Raptor-Tech/ulc-hardware/PerceptPCB_v1b.kicad_pcb

## KiCad design PerceptPCB_v1b.kicad_pcb (2026-10-30)

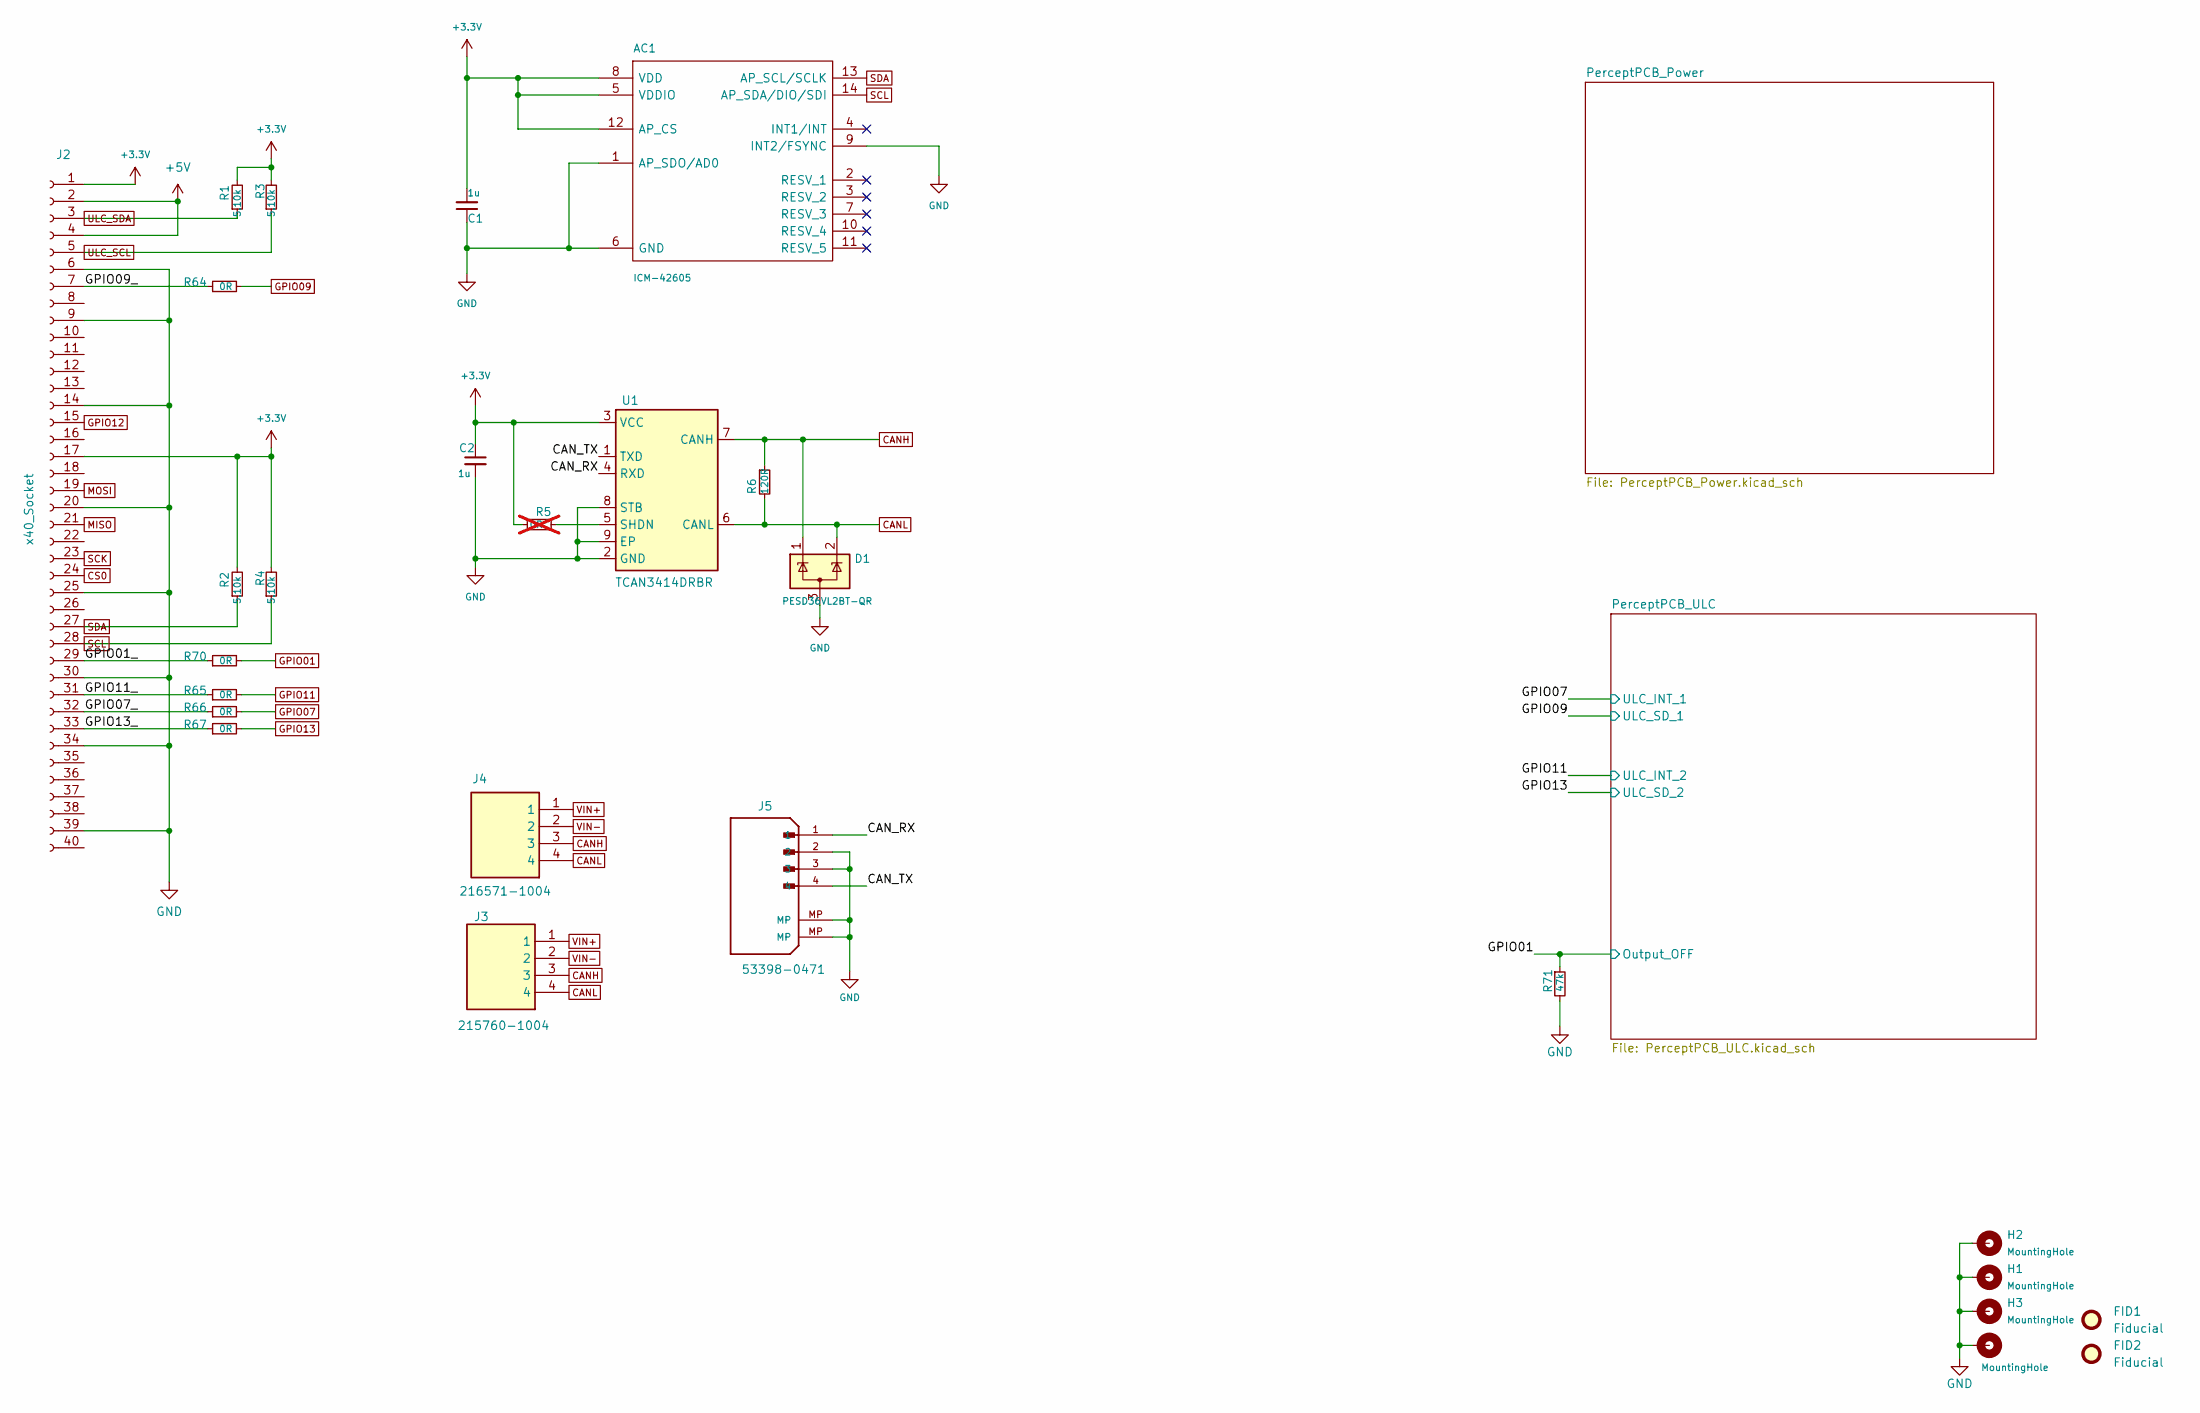
[picture p1: schematic PerceptPCB_v1b.kicad_sch, PerceptPCB v1]

Parts:
AC1: ICM-42605; IIM42352; MPN ICM-42605
C1, C2: 1u; C_0603_1608Metric; MPN C1608X7R2A105K080AC
D1: PESD36VL2BT-QR; SOT-23; MPN PESD36VL2BT-QR
FID1, FID2: Fiducial; Fiducial_1mm_Mask2mm
H1, H2, H3: MountingHole; MountingHole_2.7mm_M2.5_ISO14580_Pad
H4: MountingHole; Mounting_Wuerth_WA-SMSI-M1.6_H2.5mm_ThreadDepth1.5mm_NoNPTH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
J2: x40_Socket; PinSocket_2x20_P2.54mm_Vertical_SMD; MPN HLE-120-02-L-DV-BE-A-P-TR
J3: 215760-1004; 215760-YY04; Mouser Part Number 538-215760-1004
J4: 216571-1004; 216571-YY04_1; Mouser Part Number 538-216571-1004
J5: 53398-0471; Molex_PicoBlade_53398-0471_1x04-1MP_P1.25mm_Vertical; MPN 53398-0471
R1, R2, R3, R4: 5.10k; R_0603_1608Metric; MPN RMCF0603FT5K10
R5: 0R; R_0603_1608Metric; MPN RMCF0603ZT0R00; not fitted
R6: 120R; R_0805_2012Metric; MPN CRCW0805120RFKEA
R64, R65, R66, R67, R70: 0R; R_0603_1608Metric; MPN RMCF0603ZT0R00
R71: 47k; R_0603_1608Metric; MPN RMCF0603FT47k0
U1: TCAN3414DRBR; SON65P300X300X100-9N-D; MPN TCAN3414DRBR

Connections:
+3.3V: AC1.5 (VDDIO), AC1.8 (VDD), AC1.12 (AP_CS), C1.2, C2.1, J2.1, J2.17, R1.2, R2.2, R3.2, R4.2, R5.1, U1.3 (VCC); also elsewhere on the board
+5V: J2.2, J2.4
/CAN_RX: J5.1, U1.4 (RXD)
/CAN_TX: J5.4, U1.1 (TXD)
/GPIO01_: J2.29, R70.1
/GPIO07_: J2.32, R66.1
/GPIO09_: J2.7, R64.1
/GPIO11_: J2.31, R65.1
/GPIO13_: J2.33, R67.1
CANH: D1.1 (K), J3.3, J4.3, R6.1, U1.7 (CANH)
CANL: D1.2 (K), J3.4, J4.4, R6.2, U1.6 (CANL)
CS0: J2.24
GND: AC1.1 (AP_SDO/AD0), AC1.6 (GND), AC1.9 (INT2/FSYNC), C1.1, C2.2, D1.3 (A), H1.1, H2.1, H3.1, H4.1, J2.6, J2.9, J2.14, J2.20, J2.25, J2.30, J2.34, J2.39, J5.2, J5.3, J5.MP, R71.2, U1.2 (GND), U1.8 (STB), U1.9 (EP); also elsewhere on the board
GPIO01: R70.2, R71.1; also elsewhere on the board
GPIO07: R66.2; also elsewhere on the board
GPIO09: R64.2; also elsewhere on the board
GPIO11: R65.2; also elsewhere on the board
GPIO12: J2.15
GPIO13: R67.2; also elsewhere on the board
MISO: J2.21
MOSI: J2.19
unnamed: R5.2, U1.5 (SHDN)
SCK: J2.23
SCL: AC1.14 (AP_SDA/DIO/SDI), J2.28, R4.1
SDA: AC1.13 (AP_SCL/SCLK), J2.27, R2.1
ULC_SCL: J2.5, R3.1; also elsewhere on the board
ULC_SDA: J2.3, R1.1; also elsewhere on the board
VIN+: J3.1, J4.1; also elsewhere on the board
VIN-: J3.2, J4.2; also elsewhere on the board

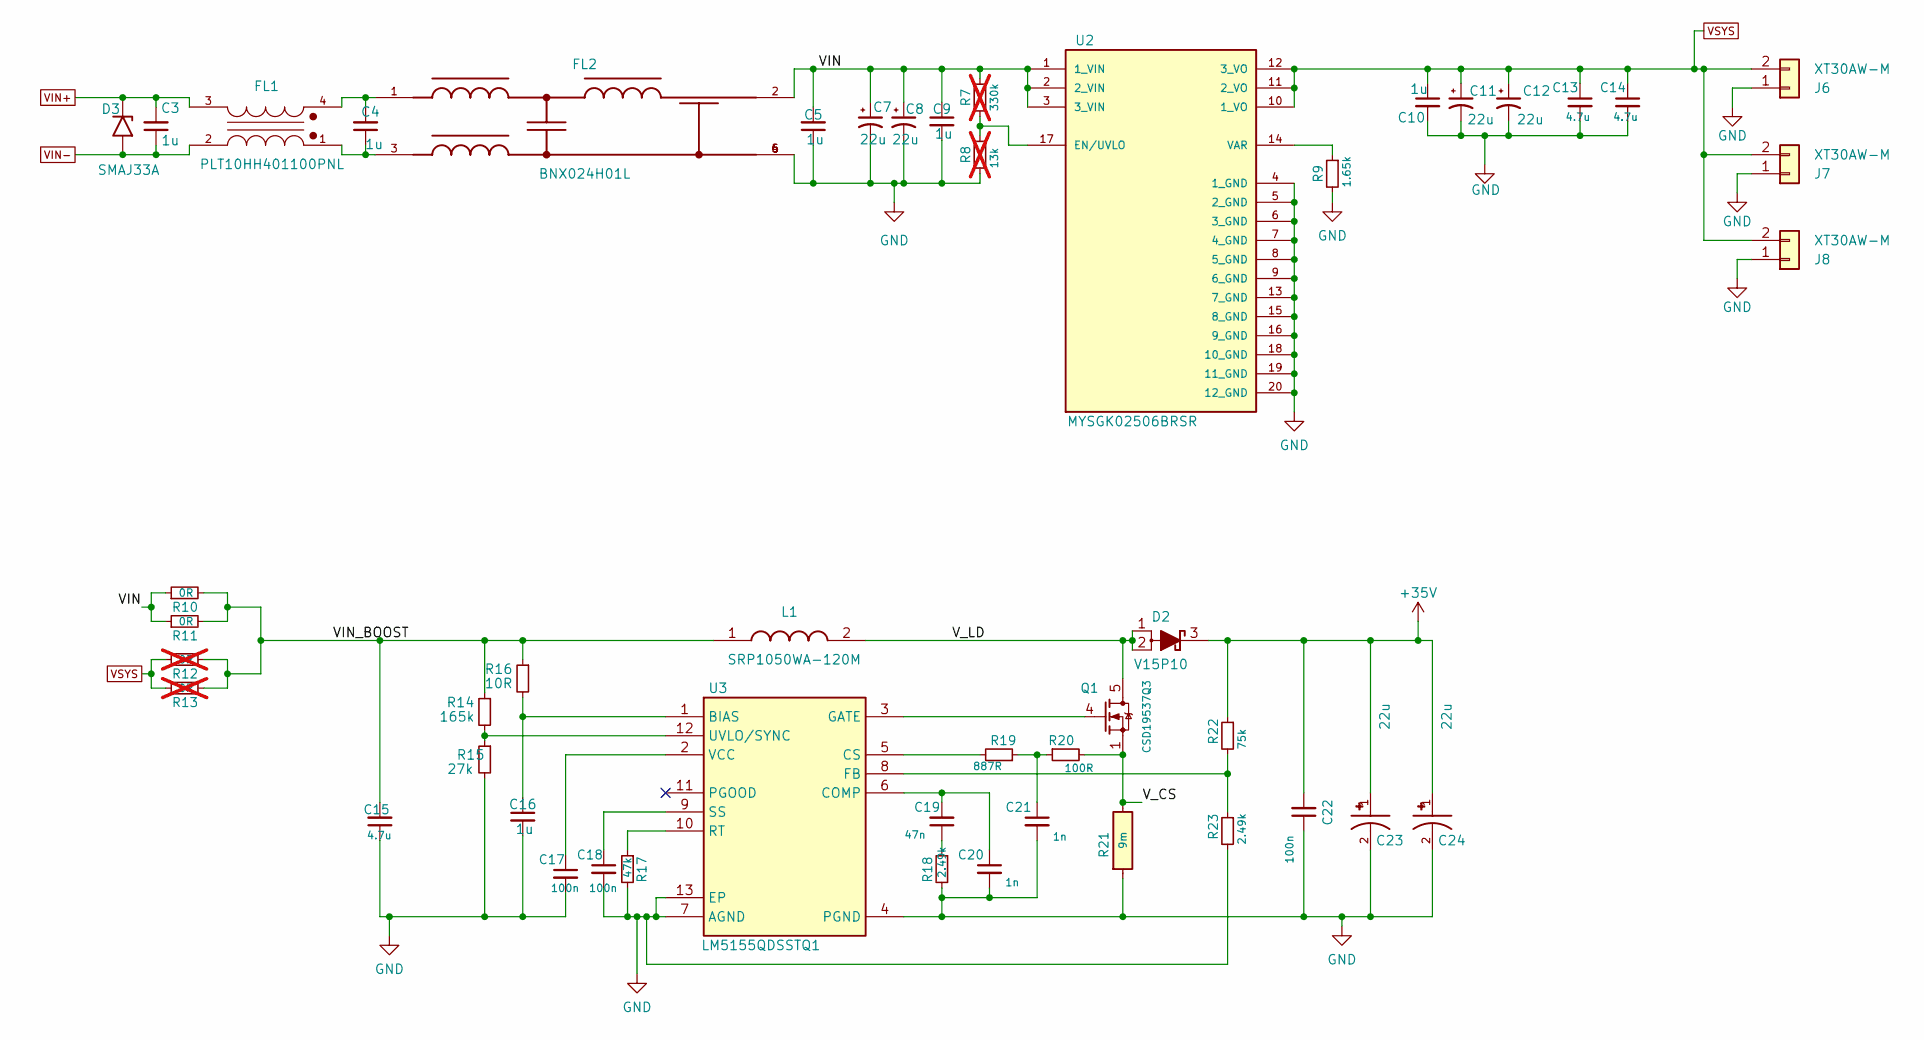
[picture p2: schematic PerceptPCB_Power.kicad_sch, PerceptPCB v1]

Parts:
C3, C4, C5: 1u; C_0805_2012Metric; MPN 08051C105K4Z2A
C7, C8, C11, C12, C23, C24: 22u; CAP_EEHZC1J220XV; MPN EEH-ZC1J220XV
C9, C10, C16: 1u; C_0603_1608Metric; MPN C1608X7R2A105K080AC
C13, C14, C15: 4.7u; C_1210_3225Metric_Pad1.33x2.70mm_HandSolder; MPN CL32B475KCVZW6E
C17, C18, C22: 100n; C_0603_1608Metric; MPN CL10B104KC8NNNC
C19: 47n; C_0603_1608Metric; MPN CL10B104KC8NNNC
C20, C21: 1n; C_0603_1608Metric; MPN GCM1885C2A102FA16D
D2: V15P10; TO-277A; MPN V15P10HM3/H
D3: SMAJ33A; D_SMA; MPN SMAJ33A
FL1: PLT10HH401100PNL; FIL_PLT10HH401100PNL
FL2: BNX024H01L; FIL_BNX024H01B; MPN BNX024H01L
J6, J7, J8: XT30AW-M; AMASS_XT30U-M_1x02_P5.0mm_Vertical; MPN XT30AW-M
L1: SRP1050WA-120M; INDPM110100X540N; MPN SRP1050WA-120M
Q1: CSD19537Q3; VSON-8_3.3x3.3mm_P0.65mm_NexFET; MPN CSD19537Q3
R7: 330k; R_0603_1608Metric; MPN CRCW0603330KFKEAC; not fitted
R8: 13k; R_0603_1608Metric; MPN CRCW060313K0FKEAC; not fitted
R9: 1.65k; R_0603_1608Metric; MPN CRCW06031K65FKEA
R10, R11: 0R; R_0603_1608Metric; MPN RMCF0603ZT0R00
R12, R13: 0R; R_0603_1608Metric; MPN RMCF0603ZT0R00; not fitted
R14: 165k; R_0603_1608Metric; MPN CRCW0603165KFKEA
R15: 27k; R_0603_1608Metric; MPN CRCW060327K0FKEA
R16: 10R; R_0603_1608Metric; MPN CRCW060310R0FKEA
R17: 47k; R_0603_1608Metric; MPN RMCF0603FT47k0
R18, R23: 2.49k; R_0603_1608Metric; MPN RMCF0603FT2K49
R19: 887R; R_0603_1608Metric; MPN CRCW0603887RFKEA
R20: 100R; R_0603_1608Metric; MPN RMCF0603FT100R
R21: 9m; R_0612_1632Metric; MPN WFCP06129L000FE66
R22: 75k; R_0603_1608Metric; MPN CRCW060375K0FKEAC
U2: MYSGK02506BRSR; MURATA_MYSGK02506BRSR_0; MOUSER_PART_NUMBER 580-MYSGK02506BRSR
U3: LM5155QDSSTQ1; SON50P200X300X80-13N-D; Mouser Part Number 595-LM5155QDSSTQ1

Connections:
+35V: C22.2, C23.1, C24.1, D2.3 (K), R22.1; also elsewhere on the board
/PerceptPCB_Power/VIN: C5.2, C7.1, C8.1, C9.1, FL2.2, R7.1, R10.1, R11.1, U2.1 (1_VIN), U2.2 (2_VIN), U2.3 (3_VIN)
/PerceptPCB_Power/VIN_BOOST: C15.2, L1.1, R10.2, R11.2, R12.2, R13.2, R14.1, R16.1
/PerceptPCB_Power/V_CS: Q1.1 (S), Q1.2 (S), Q1.3 (S), R20.2, R21.2
/PerceptPCB_Power/V_LD: D2.1 (A), D2.2 (A), L1.2, Q1.5 (D)
GND: C5.1, C7.2, C8.2, C9.2, C10.2, C11.2, C12.2, C13.2, C14.2, C15.1, C16.2, C17.2, C18.2, C20.2, C21.2, C22.1, C23.2, C24.2, FL2.4, FL2.5, FL2.6, J6.1, J7.1, J8.1, R8.2, R9.2, R15.2, R17.2, R18.2, R21.1, R23.2, U2.4 (1_GND), U2.5 (2_GND), U2.6 (3_GND), U2.7 (4_GND), U2.8 (5_GND), U2.9 (6_GND), U2.13 (7_GND), U2.15 (8_GND), U2.16 (9_GND), U2.18 (10_GND), U2.19 (11_GND), U2.20 (12_GND), U3.4 (PGND), U3.7 (AGND), U3.13 (EP); also elsewhere on the board
unnamed: C4.1, FL1.1, FL2.3
unnamed: C4.2, FL1.4, FL2.1
unnamed: C19.1, R18.1
unnamed: C21.1, R19.1, R20.1
unnamed: Q1.4 (G), U3.3 (GATE)
unnamed: R7.2, R8.1, U2.17 (EN/UVLO)
unnamed: R9.1, U2.14 (VAR)
unnamed: C16.1, R16.2, U3.1 (BIAS)
unnamed: C19.2, C20.1, U3.6 (COMP)
unnamed: R19.2, U3.5 (CS)
unnamed: R22.2, R23.1, U3.8 (FB)
unnamed: R17.1, U3.10 (RT)
unnamed: C18.1, U3.9 (SS)
unnamed: R14.2, R15.1, U3.12 (UVLO/SYNC)
unnamed: C17.1, U3.2 (VCC)
VIN+: C3.2, D3.1 (A1), FL1.3; also elsewhere on the board
VIN-: C3.1, D3.2 (A2), FL1.2; also elsewhere on the board
VSYS: C10.1, C11.1, C12.1, C13.1, C14.1, J6.2, J7.2, J8.2, R12.1, R13.1, U2.10 (1_VO), U2.11 (2_VO), U2.12 (3_VO)

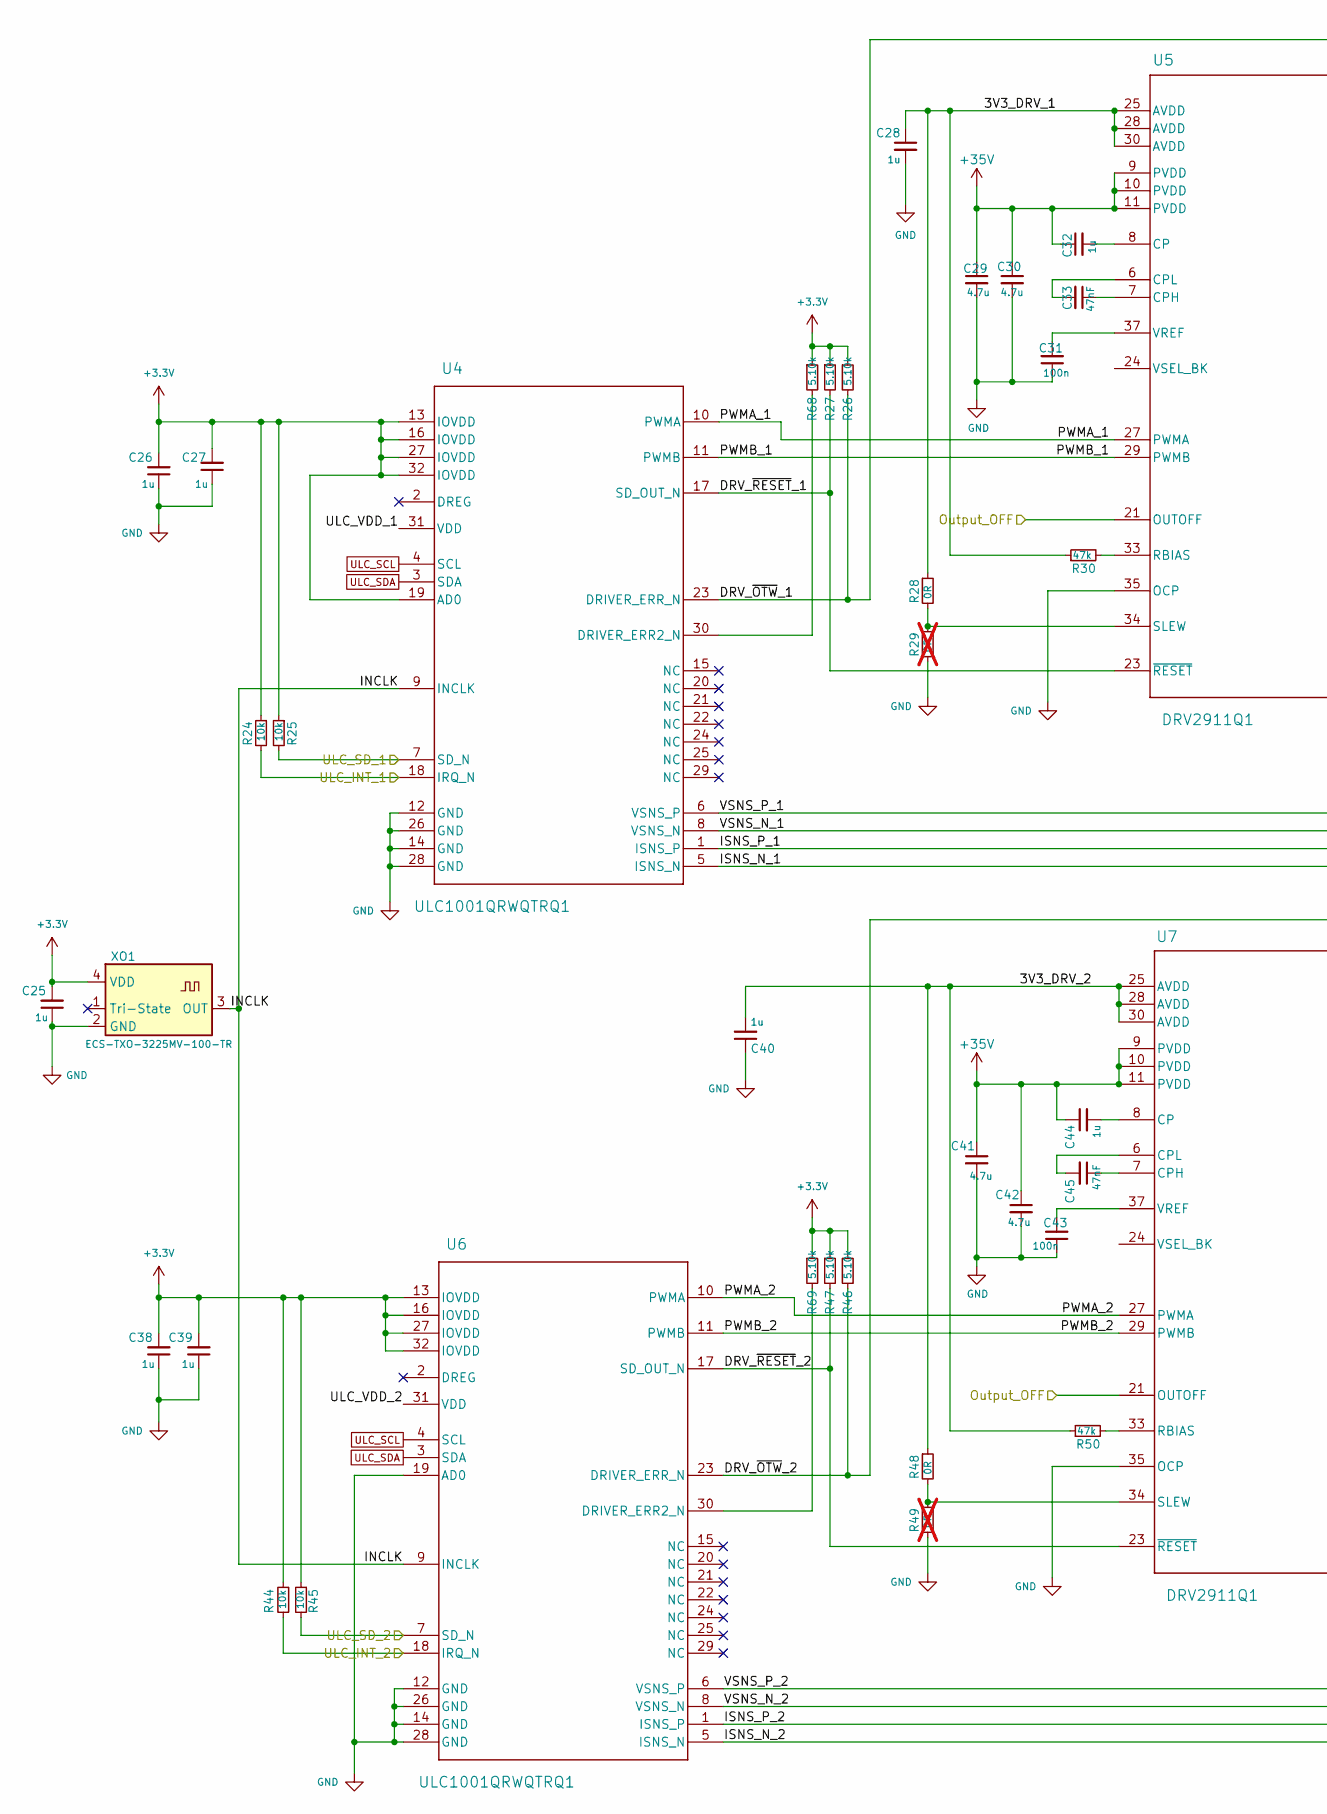
[picture p3: schematic PerceptPCB_ULC.kicad_sch, PerceptPCB v1, part in row 1, column 1]

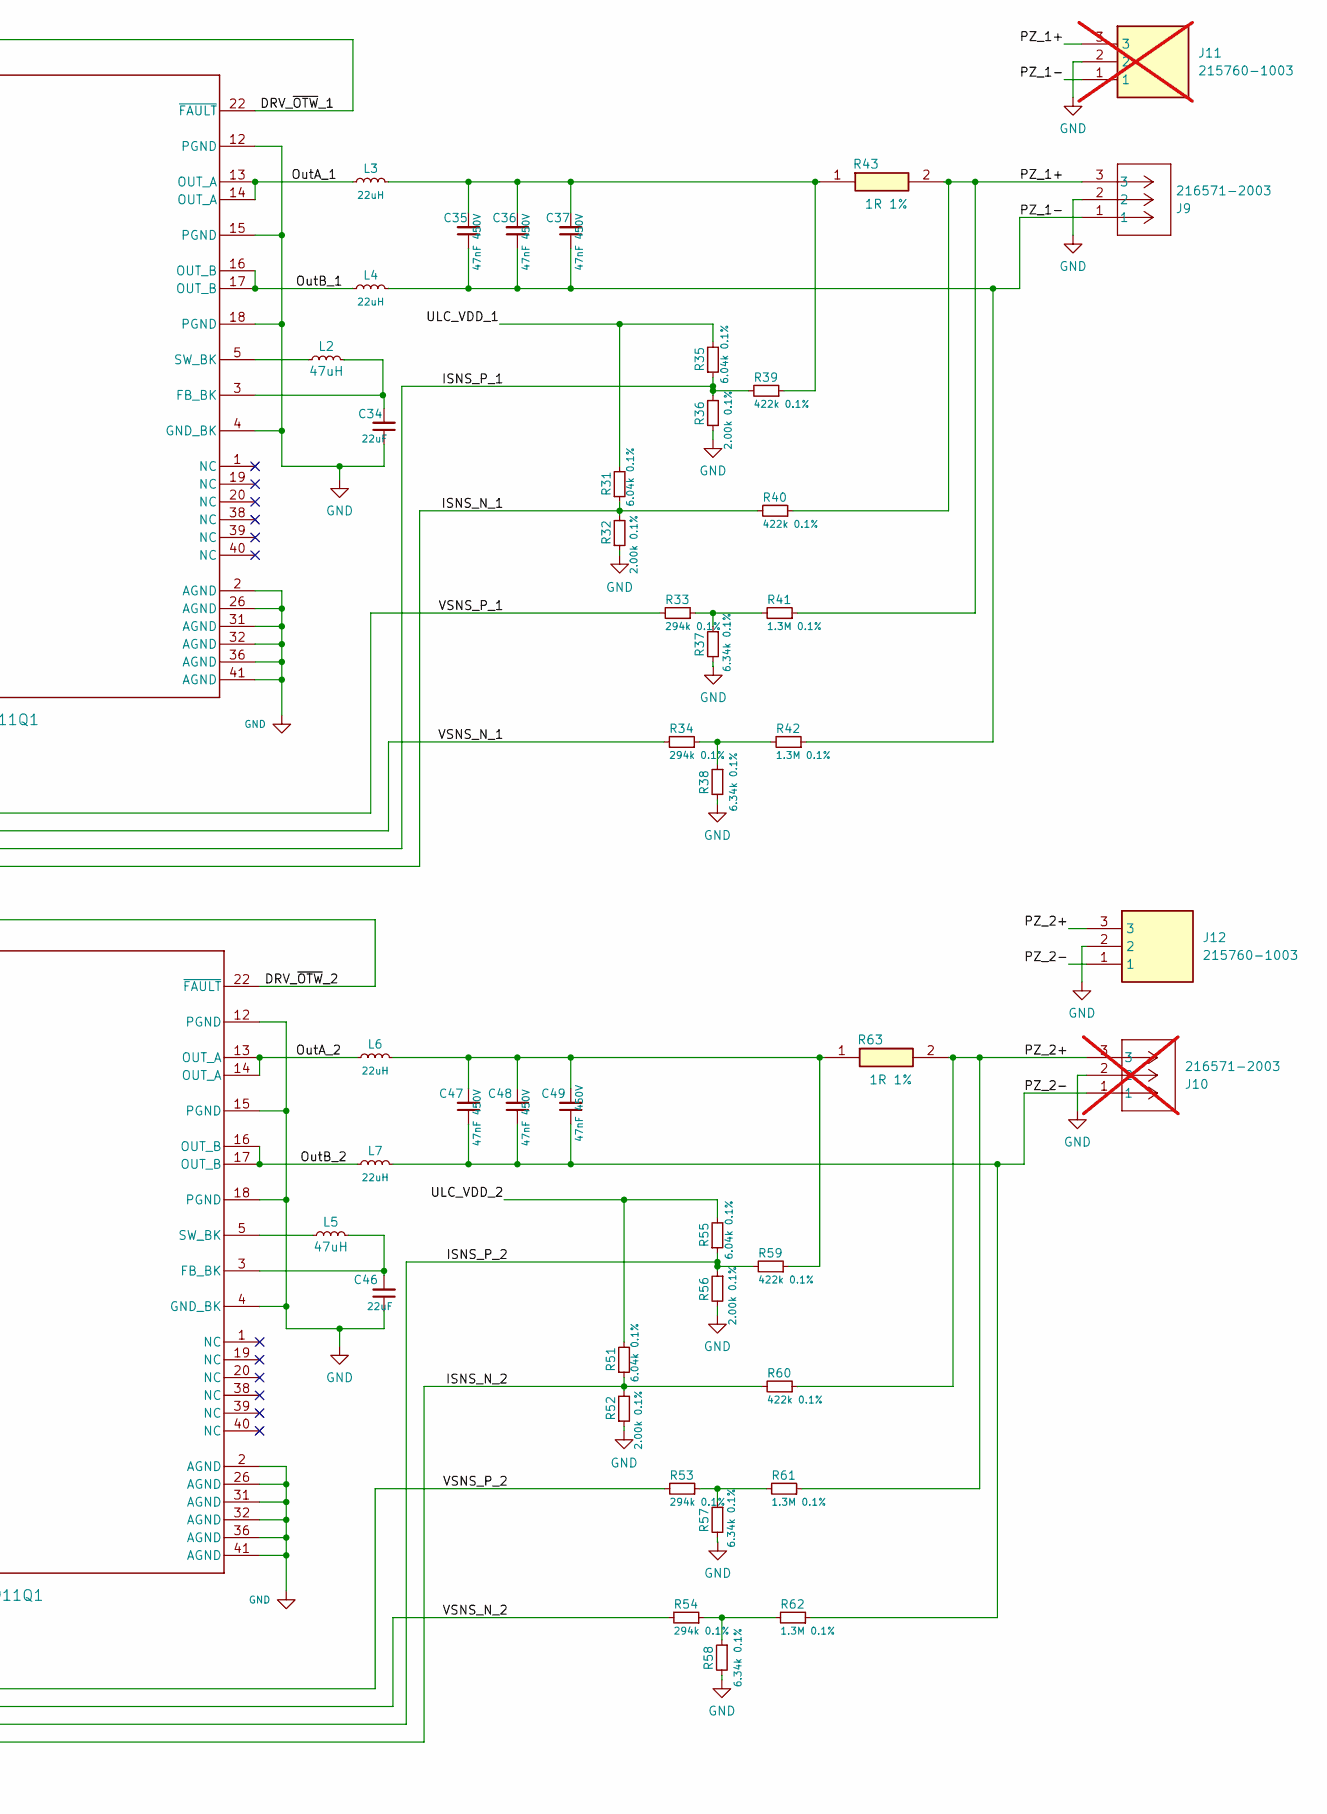
[picture p4: schematic PerceptPCB_ULC.kicad_sch, PerceptPCB v1, part in row 1, column 2]

Parts:
C25, C26, C27, C28, C32, C38, C39, C40, C44: 1u; C_0603_1608Metric; MPN C1608X7R2A105K080AC
C29, C30, C41, C42: 4.7u; C_1210_3225Metric_Pad1.33x2.70mm_HandSolder; MPN CL32B475KCVZW6E
C31, C43: 100n; C_0603_1608Metric; MPN CL10B104KC8NNNC
C33, C45: 47nF; C_0603_1608Metric; MPN C0603C473K5RACTU
C34, C46: 22uF; C_0603_1608Metric; MPN CC0603MRX5R6BB226
C35, C36, C37, C47, C48, C49: 47nF 450V; C_1210_3225Metric_Pad1.33x2.70mm_HandSolder; MPN CGA6M4X7R2J473K200AA
J9: 216571-2003; CONN03_2165712003_MOL; Mouser Part Number 538-215760-1003
J10: 216571-2003; CONN03_2165712003_MOL; Mouser Part Number 538-215760-1003; not fitted
J11: 215760-1003; 215760-YY03; Mouser Part Number 538-215760-1003; not fitted
J12: 215760-1003; 215760-YY03; Mouser Part Number 538-215760-1003
L2, L5: 47uH; L_0805_2012Metric; MPN LQM21DN470M70L
L3, L4, L6, L7: 22uH; 0630CDMCCDS-100MC; PartNumber 0630CDMCCDS-100MC
R24, R25, R44, R45: 10k; R_0603_1608Metric; MPN RMCF0603FT10K0
R26, R27, R46, R47, R68, R69: 5.10k; R_0603_1608Metric; MPN RMCF0603FT5K10
R28, R48: 0R; R_0603_1608Metric; MPN RMCF0603ZT0R00
R29, R49: 0R; R_0603_1608Metric; MPN RMCF0603ZT0R00; not fitted
R30, R50: 47k; R_0603_1608Metric; MPN RMCF0603FT47k0
R31, R35, R51, R55: 6.04k 0.1%; R_0603_1608Metric; MPN TNPW06036K04BEEA
R32, R36, R52, R56: 2.00k 0.1%; R_0603_1608Metric; MPN TNPW06032K00BEEA
R33, R34, R53, R54: 294k 0.1%; R_0603_1608Metric; MPN TNPW0603294KBEEA
R37, R38, R57, R58: 6.34k 0.1%; R_0603_1608Metric; MPN TNPW06036K34BEEA
R39, R40, R59, R60: 422k 0.1%; R_1206_3216Metric; MPN TNPW1206422KBEEA
R41, R42, R61, R62: 1.3M 0.1%; R_1206_3216Metric; MPN RGV3216P-1304-B-T1
R43, R63: 1R 1%; RESC3263X80N; MPN RCL12251R00FKEG
U4, U6: ULC1001QRWQTRQ1; RQT0032A-MFG; MPN ULC1001QRWQTRQ1
U5, U7: DRV2911Q1; QFN50P500X700X100-41N-D; MPN DRV2911Q1
XO1: ECS-TXO-3225MV-100-TR; ECSTXO3225MV100TR; MPN ECS-TXO-3225MV-100-TR

Connections:
+3.3V: C25.2, C26.2, C27.2, C38.2, C39.2, R24.1, R25.1, R26.1, R27.1, R44.1, R45.1, R46.1, R47.1, R68.1, R69.1, U4.13 (IOVDD), U4.16 (IOVDD), U4.19 (AD0), U4.27 (IOVDD), U4.32 (IOVDD), U6.13 (IOVDD), U6.16 (IOVDD), U6.27 (IOVDD), U6.32 (IOVDD), XO1.4 (VDD); also elsewhere on the board
+35V: C29.1, C30.1, C32.1, C41.1, C42.1, C44.1, U5.9 (PVDD), U5.10 (PVDD), U5.11 (PVDD), U7.9 (PVDD), U7.10 (PVDD), U7.11 (PVDD); also elsewhere on the board
/PerceptPCB_ULC/3V3_DRV_1: C28.1, R28.1, R30.1, U5.25 (AVDD), U5.28 (AVDD), U5.30 (AVDD)
/PerceptPCB_ULC/3V3_DRV_2: C40.2, R48.1, R50.1, U7.25 (AVDD), U7.28 (AVDD), U7.30 (AVDD)
/PerceptPCB_ULC/DRV_~OTW_1: R26.2, U4.23 (DRIVER_ERR_N), U5.22 (~FAULT)
/PerceptPCB_ULC/DRV_~OTW_2: R46.2, U6.23 (DRIVER_ERR_N), U7.22 (~FAULT)
/PerceptPCB_ULC/DRV_~RESET_1: R27.2, U4.17 (SD_OUT_N), U5.23 (~RESET)
/PerceptPCB_ULC/DRV_~RESET_2: R47.2, U6.17 (SD_OUT_N), U7.23 (~RESET)
/PerceptPCB_ULC/INCLK: U4.9 (INCLK), U6.9 (INCLK), XO1.3 (OUT)
/PerceptPCB_ULC/ISNS_N_1: R31.1, R32.2, R40.2, U4.5 (ISNS_N)
/PerceptPCB_ULC/ISNS_N_2: R51.1, R52.2, R60.2, U6.5 (ISNS_N)
/PerceptPCB_ULC/ISNS_P_1: R35.1, R36.1, R39.2, U4.1 (ISNS_P)
/PerceptPCB_ULC/ISNS_P_2: R55.1, R56.1, R59.2, U6.1 (ISNS_P)
/PerceptPCB_ULC/OutA_1: L3.1, U5.13 (OUT_A), U5.14 (OUT_A)
/PerceptPCB_ULC/OutA_2: L6.1, U7.13 (OUT_A), U7.14 (OUT_A)
/PerceptPCB_ULC/OutB_1: L4.1, U5.16 (OUT_B), U5.17 (OUT_B)
/PerceptPCB_ULC/OutB_2: L7.1, U7.16 (OUT_B), U7.17 (OUT_B)
/PerceptPCB_ULC/PWMA_1: U4.10 (PWMA), U5.27 (PWMA)
/PerceptPCB_ULC/PWMA_2: U6.10 (PWMA), U7.27 (PWMA)
/PerceptPCB_ULC/PWMB_1: U4.11 (PWMB), U5.29 (PWMB)
/PerceptPCB_ULC/PWMB_2: U6.11 (PWMB), U7.29 (PWMB)
/PerceptPCB_ULC/PZ_1+: J9.3, J11.3, R40.1, R41.1, R43.2
/PerceptPCB_ULC/PZ_1-: C35.1, C36.1, C37.1, J9.1, J11.1, L4.2, R42.1
/PerceptPCB_ULC/PZ_2+: J10.3, J12.3, R60.1, R61.1, R63.2
/PerceptPCB_ULC/PZ_2-: C47.1, C48.1, C49.1, J10.1, J12.1, L7.2, R62.1
/PerceptPCB_ULC/ULC_VDD_1: R31.2, R35.2, U4.31 (VDD)
/PerceptPCB_ULC/ULC_VDD_2: R51.2, R55.2, U6.31 (VDD)
/PerceptPCB_ULC/VSNS_N_1: R34.2, U4.8 (VSNS_N)
/PerceptPCB_ULC/VSNS_N_2: R54.2, U6.8 (VSNS_N)
/PerceptPCB_ULC/VSNS_P_1: R33.2, U4.6 (VSNS_P)
/PerceptPCB_ULC/VSNS_P_2: R53.2, U6.6 (VSNS_P)
GND: C25.1, C26.1, C27.1, C28.2, C29.2, C30.2, C31.1, C34.1, C38.1, C39.1, C40.1, C41.2, C42.2, C43.1, C46.1, J9.2, J10.2, J11.2, J12.2, R29.2, R32.1, R36.2, R37.2, R38.2, R49.2, R52.1, R56.2, R57.2, R58.2, U4.12 (GND), U4.14 (GND), U4.26 (GND), U4.28 (GND), U5.2 (AGND), U5.4 (GND_BK), U5.12 (PGND), U5.15 (PGND), U5.18 (PGND), U5.26 (AGND), U5.31 (AGND), U5.32 (AGND), U5.35 (OCP), U5.36 (AGND), U5.41 (AGND), U6.12 (GND), U6.14 (GND), U6.19 (AD0), U6.26 (GND), U6.28 (GND), U7.2 (AGND), U7.4 (GND_BK), U7.12 (PGND), U7.15 (PGND), U7.18 (PGND), U7.26 (AGND), U7.31 (AGND), U7.32 (AGND), U7.35 (OCP), U7.36 (AGND), U7.41 (AGND), XO1.2 (GND); also elsewhere on the board
GPIO01: U5.21 (OUTOFF), U7.21 (OUTOFF); also elsewhere on the board
GPIO07: R24.2, U4.18 (IRQ_N); also elsewhere on the board
GPIO09: R25.2, U4.7 (SD_N); also elsewhere on the board
GPIO11: R44.2, U6.18 (IRQ_N); also elsewhere on the board
GPIO13: R45.2, U6.7 (SD_N); also elsewhere on the board
unnamed: C35.2, C36.2, C37.2, L3.2, R39.1, R43.1
unnamed: C47.2, C48.2, C49.2, L6.2, R59.1, R63.1
unnamed: R33.1, R37.1, R41.2
unnamed: R34.1, R38.1, R42.2
unnamed: R53.1, R57.1, R61.2
unnamed: R54.1, R58.1, R62.2
unnamed: R68.2, U4.30 (DRIVER_ERR2_N)
unnamed: C32.2, U5.8 (CP)
unnamed: C33.1, U5.7 (CPH)
unnamed: C33.2, U5.6 (CPL)
unnamed: C34.2, L2.2, U5.3 (FB_BK)
unnamed: R30.2, U5.33 (RBIAS)
unnamed: R28.2, R29.1, U5.34 (SLEW)
unnamed: L2.1, U5.5 (SW_BK)
unnamed: C31.2, U5.37 (VREF)
unnamed: R69.2, U6.30 (DRIVER_ERR2_N)
unnamed: C44.2, U7.8 (CP)
unnamed: C45.1, U7.7 (CPH)
unnamed: C45.2, U7.6 (CPL)
unnamed: C46.2, L5.2, U7.3 (FB_BK)
unnamed: R50.2, U7.33 (RBIAS)
unnamed: R48.2, R49.1, U7.34 (SLEW)
unnamed: L5.1, U7.5 (SW_BK)
unnamed: C43.2, U7.37 (VREF)
ULC_SCL: U4.4 (SCL), U6.4 (SCL); also elsewhere on the board
ULC_SDA: U4.3 (SDA), U6.3 (SDA); also elsewhere on the board

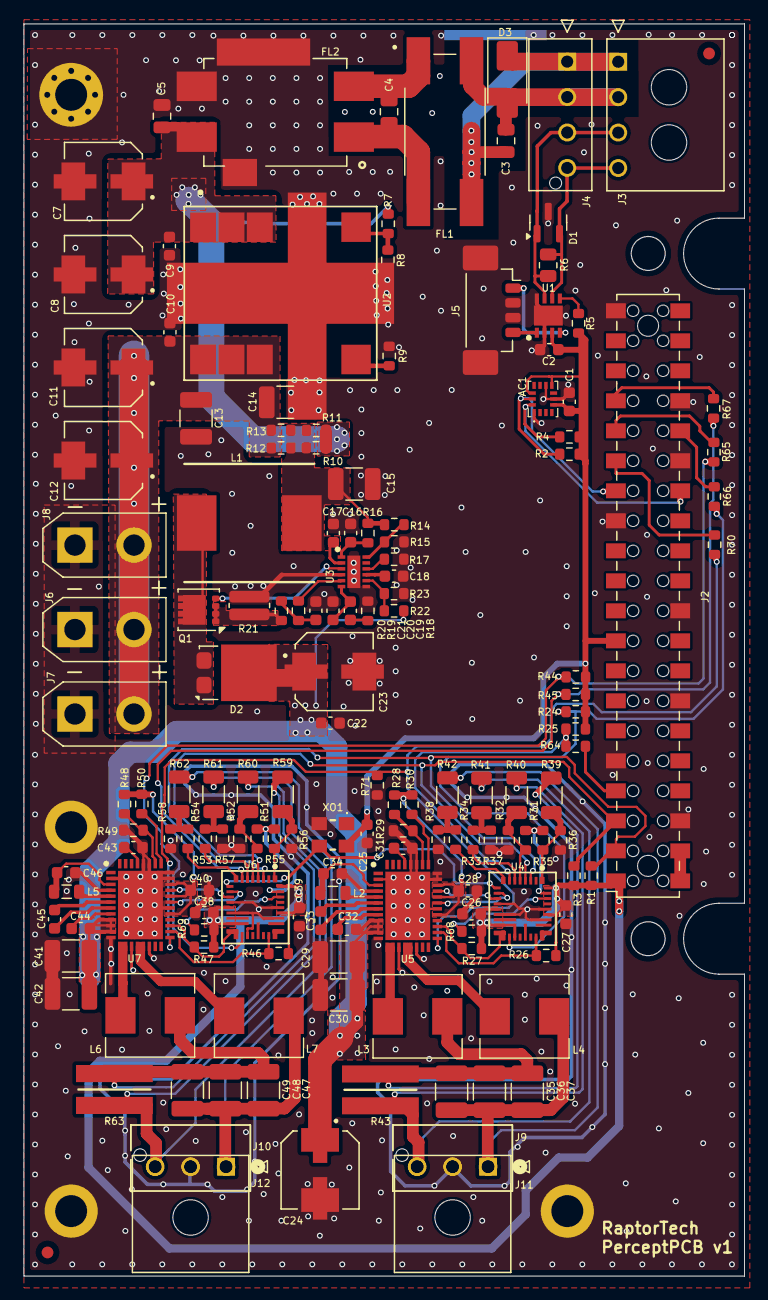
[picture p5: board PerceptPCB_v1b.kicad_pcb from above]

Board: 4 copper layers, 61.0 x 106.0 mm, 158 parts (0 on the bottom side), 98 nets.
