Raptor-Tech/ulc-hardware/(commit log)

2026-10-30 fix: first commit
    [PerceptPCB_Power.kicad_sch, PerceptPCB_ULC.kicad_sch, PerceptPCB_v1b.kicad_pcb, PerceptPCB_v1b.kicad_sch]
2026-10-30 fix: tickling bom; fix kibot errs
